kpezeshki/portaPLUTO/plutopack_frontend_pcb/plutopack/production/bom.csv

Designator | Footprint | Quantity | Value | LCSC Part #
A2 | RaspberryPi_Pico_SMD_HandSolder | 1 | RaspberryPi_Pico
C1, C12, C2, C9 | 0603 | 4 | 100n
C10, C11, C3, C4 | 0603 | 4 | 10u
C13, C14, C6, C8, FB1, FB2 | 0603 | 6 | ~
C15, C20 | 0603 | 2 | 0.1u
C16, C5 | CP_EIA-7343-31_Kemet-D | 2 | 100u
C17, C21 | 0603 | 2 | 4u7
C18, C7 | 0603 | 2 | 1u
C19 | 0603 | 1 | 0.47u
C22, C23, C24, C25, C26, C27, C28, C29, C30 | 0603 | 9 | 10n
D1, D2, D3, D4, D9 | 0603 | 5 | LED
D5 | D_SOD-123 | 1 | D_Schottky
D6, D7, D8 | SOT-23 | 3 | SP0502BAHT
J1 | PinHeader_2x10_P2.54mm_Vertical | 1 | Conn_02x10_Odd_Even
J2 | Amphenol_F32Q-1A7x1-11050_1x50-1MP_P0.5mm_Horizontal | 1 | Conn_01x50
J3 | BatteryHolder_Keystone_1042_1x18650 | 1 | Battery_Cell
J4 | PinSocket_1x06_P2.54mm_Horizontal | 1 | Conn_01x06_Pin
J5 | USB_C_Receptacle_GCT_USB4125-xx-x-0190_6P_TopMnt_Horizontal | 1 | USB_C_Receptacle_PowerOnly_6P
J6 | PinSocket_2x05_P1.27mm_Vertical_SMD | 1 | Conn_02x05_Odd_Even
JP1, JP2, JP3, JP4 | SolderJumper-2_P1.3mm_Bridged_RoundedPad1.0x1.5mm | 4 | Jumper_2_Bridged
L1, L2 | L_12x12mm_H4.5mm | 2 | 1u2
Q1, Q4 | SOT-23 | 2 | AO3401A
Q2, Q3 | SOT-23 | 2 | AO3400A
R1, R2, R3, R32, R33, R4 | 0603 | 6 | 10
R10, R13, R19, R20, R21, R22, R23, R24, R25, R26, R27, R28, R29, R30, R31, R7 | 0603 | 16 | 10k
R11, R12, R14, R15, R43, R44, R51, R52, R53, R54, R55, R56, R57, R58 | 0603 | 14 | 1k
R16 | 0603 | 1 | 10m
R17, R18, R49, R50 | 0603 | 4 | 5k1
R34, R35, R36, R37, R38, R39, R40 | 0603 | 7 | 0
R41, R42 | 0603 | 2 | 100k
R45 | 0603 | 1 | 330
R46, R47 | 0603 | 2 | 5M
R48 | 0603 | 1 | 2k2
R5 | 0603 | 1 | 1M6
R6, R9 | 0603 | 2 | 180k
R8 | 0603 | 1 | 1M
SW1, SW3, SW4, SW5, SW6, SW7, SW8 | SW_Push_1P1T_NO_CK_KSC6xxG | 7 | SW_Push
SW10 | SW_Slide_SPDT_Straight_CK_OS102011MS2Q | 1 | SW_SPDT
SW2 | RotaryEncoder_Alps_EC12E_Vertical_H20mm | 1 | RotaryEncoder
TP1, TP2, TP3, TP4, TP5 | TestPoint_THTPad_D1.5mm_Drill0.7mm | 5 | TestPoint
TP6, TP7, TP8 | TestPoint_Pad_D1.0mm | 3 | TestPoint
U1 | VQFN-16-1EP_3x3mm_P0.5mm_EP1.6x1.6mm | 1 | BQ24075RGT
U2 | SOP65P640X120-16N | 1 | TSC2007IPWR
U3, U5 | QFN14_1 | 2 | TPS63020
U4 | Texas_S-PDSO-N12 | 1 | BQ27441-G1
U6 | WSON-6_1.5x1.5mm_P0.5mm | 1 | BQ297xy
U7 | TSSOP-20_4.4x6.5mm_P0.65mm | 1 | TXS0108EPW
