kpezeshki/portaPLUTO/plutopack_frontend_pcb/plutopack/production/plutopack_V6_JLC_assembly_bom.csv

Comment | Designator | Footprint | JLCPCB Part #
100n | C1, C12, C2, C9 | 0603 | C1591
10u | C10, C11, C3, C4 | 0603 | C19702
0 (was ferrite) | FB1, FB2 | 0603 | C95177
10u (conv. output) | C14, C6 | 0603 | C19702
0.1u | C15, C20 | 0603 | C1591
4u7 | C17, C21 | 0603 | C19666
1u | C18, C7 | 0603 | C15849
0.47u | C19 | 0603 | C1623
10n | C22, C23, C24, C25, C26, C27, C28, C29, C30 | 0603 | C57112
LED | D1, D2, D3, D4, D9 | 0603 | C2286
D_Schottky | D5 | D_SOD-123 | C8598
SP0502BAHT | D6, D7, D8 | SOT-23 | C32677
AO3401A | Q1, Q4 | SOT-23 | C15127
AO3400A | Q2, Q3 | SOT-23 | C20917
10 | R1, R2, R3, R32, R33, R4 | 0603 | C22859
10k | R10, R13, R19, R20, R21, R22, R23, R24, R25, R26, R27, R28, R29, R30, R31, R7 | 0603 | C98220
1k | R11, R12, R14, R15, R43, R44, R51, R52, R53, R54, R55, R56, R57, R58 | 0603 | C21190
5k1 | R17, R18, R49, R50 | 0603 | C23186
0 | R34, R35, R36, R37, R38, R39, R40 | 0603 | C95177
100k | R41, R42 | 0603 | C25803
330 | R45 | 0603 | C23138
2k2 | R48 | 0603 | C4190
1M | R8 | 0603 | C22935
BQ24075RGT | U1 | VQFN-16-1EP_3x3mm_P0.5mm_EP1.6x1.6mm | C15464
TPS63020 | U3, U5 | QFN14_1 | C15483
BQ27441-G1 | U4 | Texas_S-PDSO-N12 | C473397
BQ297xy | U6 | WSON-6_1.5x1.5mm_P0.5mm | C183096
