kpezeshki/portaPLUTO/plutopack_frontend_pcb/plutopack/plutopack.step

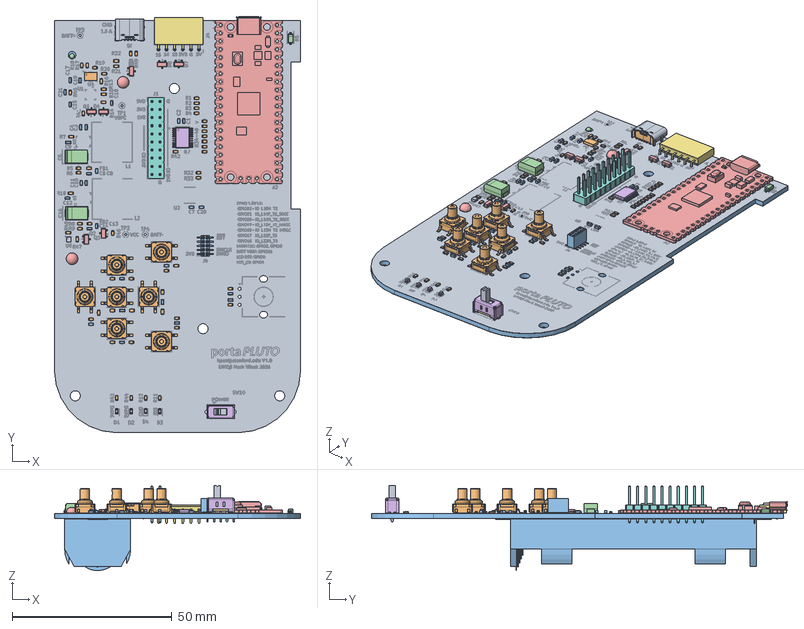
[picture p1: CAD file, 2026-08-21]
plutopack_frontend_pcb/plutopack/plutopack.step
77.0 x 130.2 x 26.7 mm
R_0603_1608Metric x 59
C_0603_1608Metric x 28
CP_EIA-7343-31_Kemet-D x 2
SOT-23 x 7
SW_Slide_SPDT_Straight_CK_OS102011MS2Q
SW_Push_1P1T_NO_CK_KSC6xxG x 7
PinSocket_2x05_P1.27mm_Vertical_SMD
D_SOD-123
RaspberryPi_Pico_Module_KiCad
LED_0603_1608Metric x 4
USB_C_Receptacle_GCT_USB4125-xx-x-0190_6P_TopMnt_Horizontal
TSSOP-20_4.4x6.5mm_P0.65mm
PinSocket_1x06_P2.54mm_Horizontal
PinHeader_2x10_P2.54mm_Vertical
WSON-6_1.5x1.5mm_P0.5mm
Texas_S-PDSO-N12
BatteryHolder_Keystone_1042_1x18650
plutopack_silkscreen
plutopack_soldermask
plutopack_PCB
