kpezeshki/portaPLUTO/plutopack_frontend_pcb/TPS63020/TPS63020.step

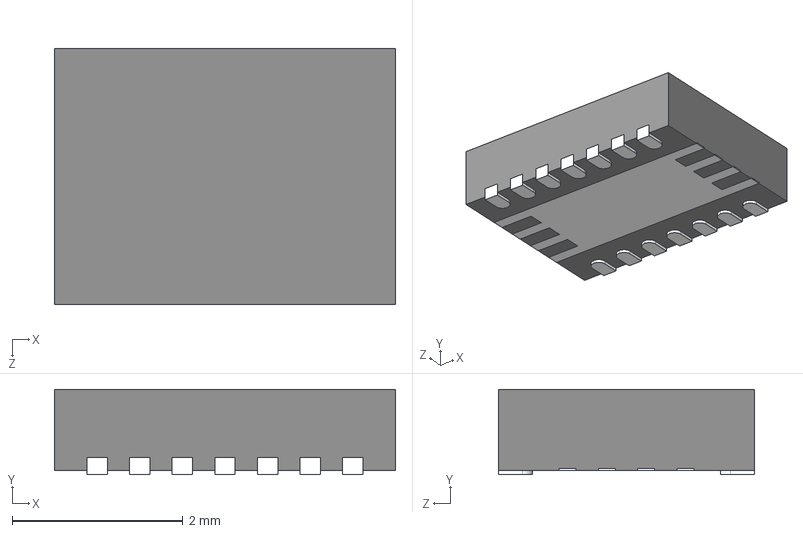
[picture p2: CAD file, 2026-08-21]
plutopack_frontend_pcb/TPS63020/TPS63020.step
4.00 x 1.00 x 3.00 mm
