kpezeshki/portaPLUTO/(list of files, cad)

Other CAD files:
plutopack_mechanics/Al_Midplate.f3d
plutopack_mechanics/buffer_block_bottom.f3d
plutopack_mechanics/cover_back_full.f3d
plutopack_mechanics/knob_ec12.f3d
plutopack_mechanics/knob_ec12_3dprint.f3d
plutopack_mechanics/knob_ec12_insert.f3d
plutopack_mechanics/pcb_display_mount.f3d
