kpezeshki/portaPLUTO/plutopack_mechanics/Al_Midplate_for_ext_machining Drawing.pdf

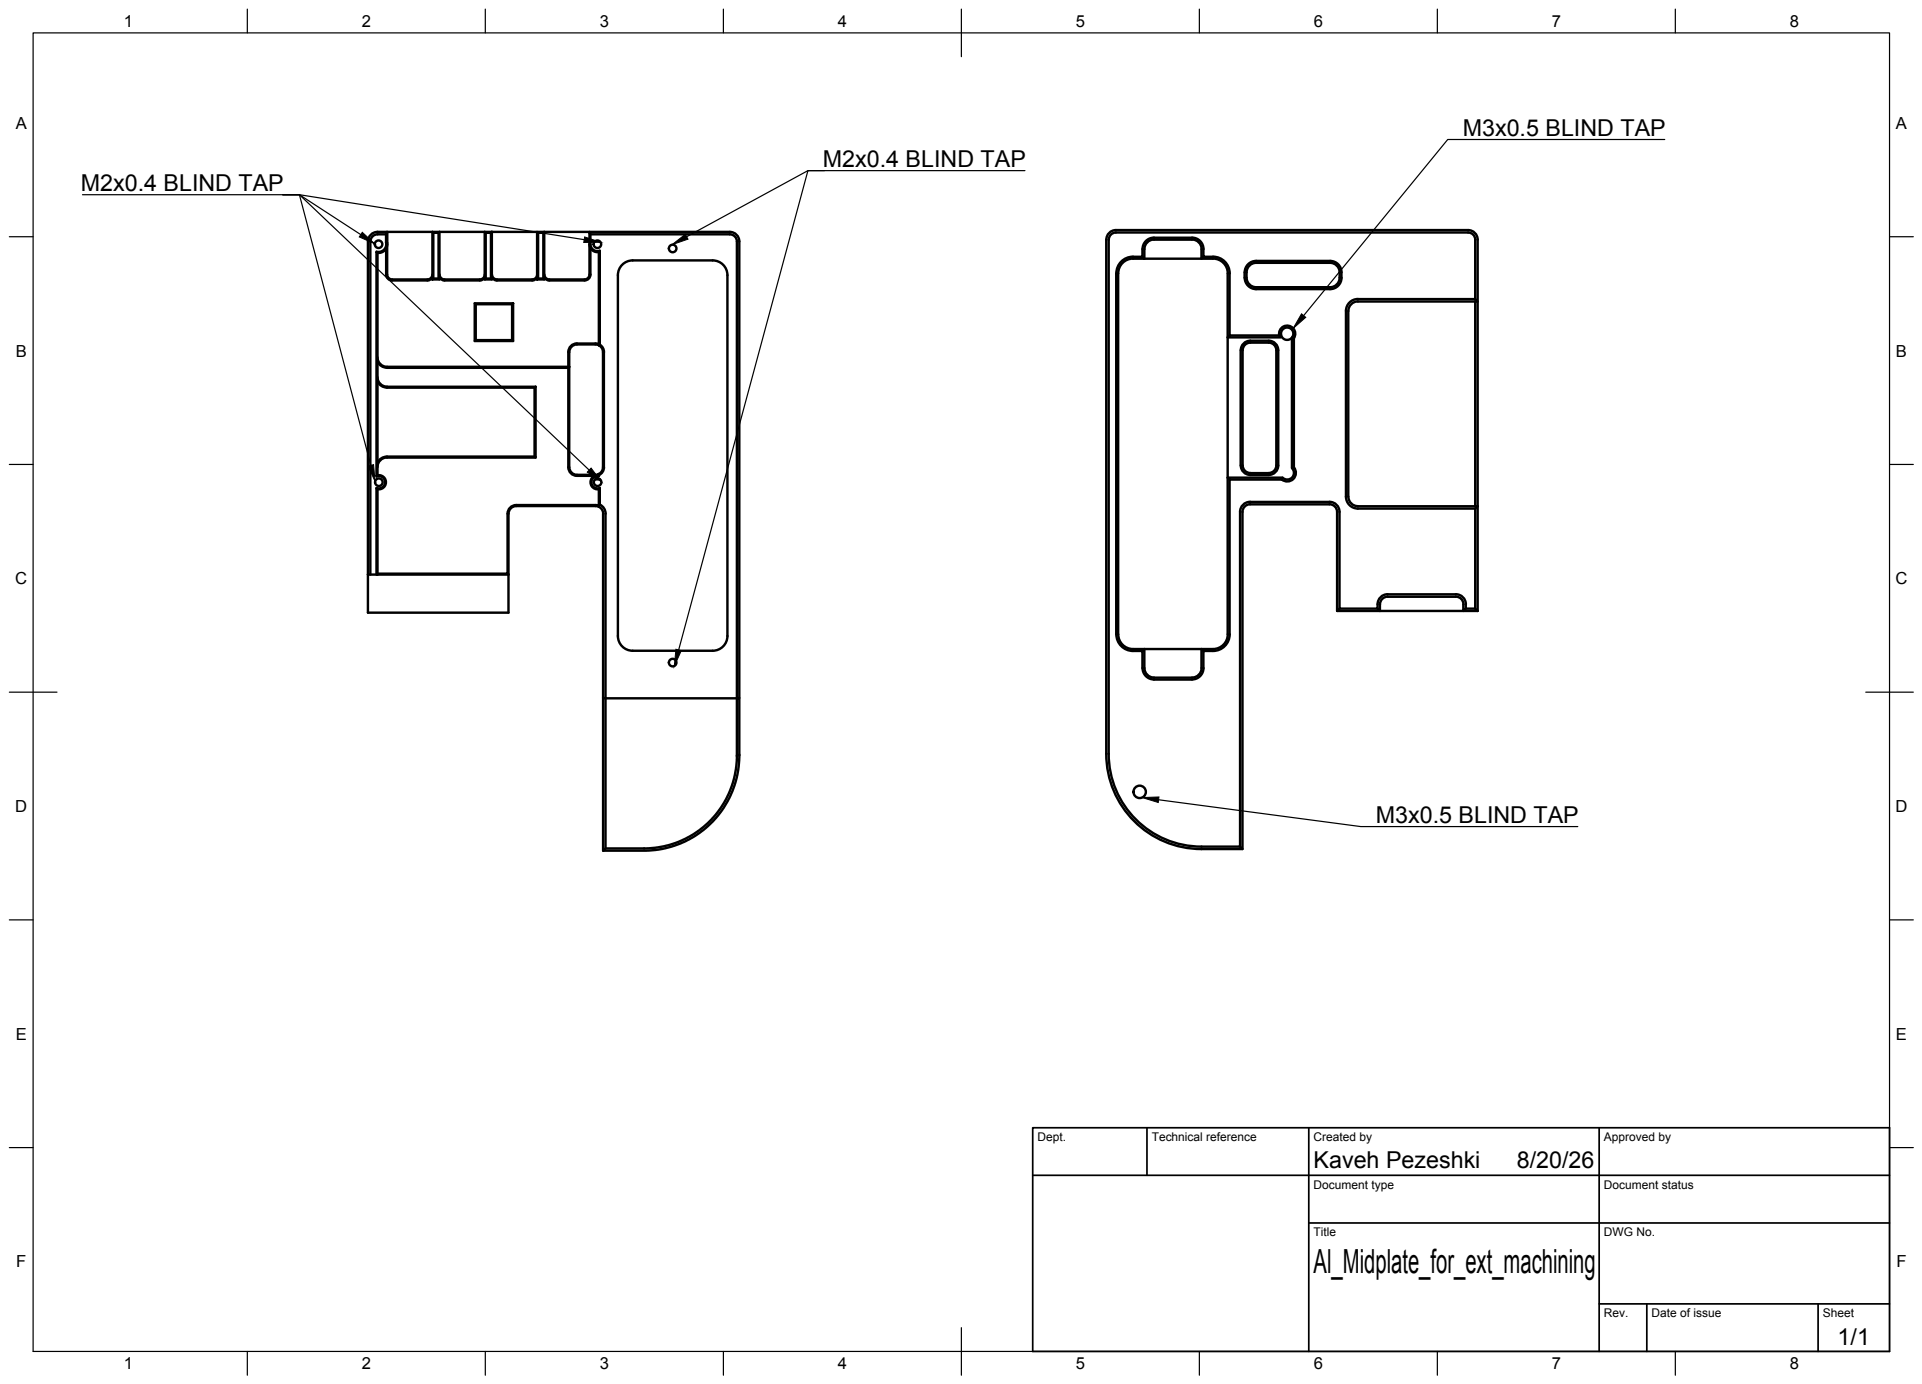
[picture p3: page 1]
Title; DWG No.; Rev.; Date of issue; Sheet; M3x0.5 BLIND TAP; M2x0.4 BLIND TAP

Dept. | Technical reference | Created by Kaveh Pezeshki 8/20/26 | Approved by

Document type | Document status
