kpezeshki/portaPLUTO/plutopack_frontend_pcb/plutopack/plutopack.kicad_pcb

## KiCad design plutopack_frontend_pcb/plutopack/plutopack.kicad_pcb (2026-10-26)

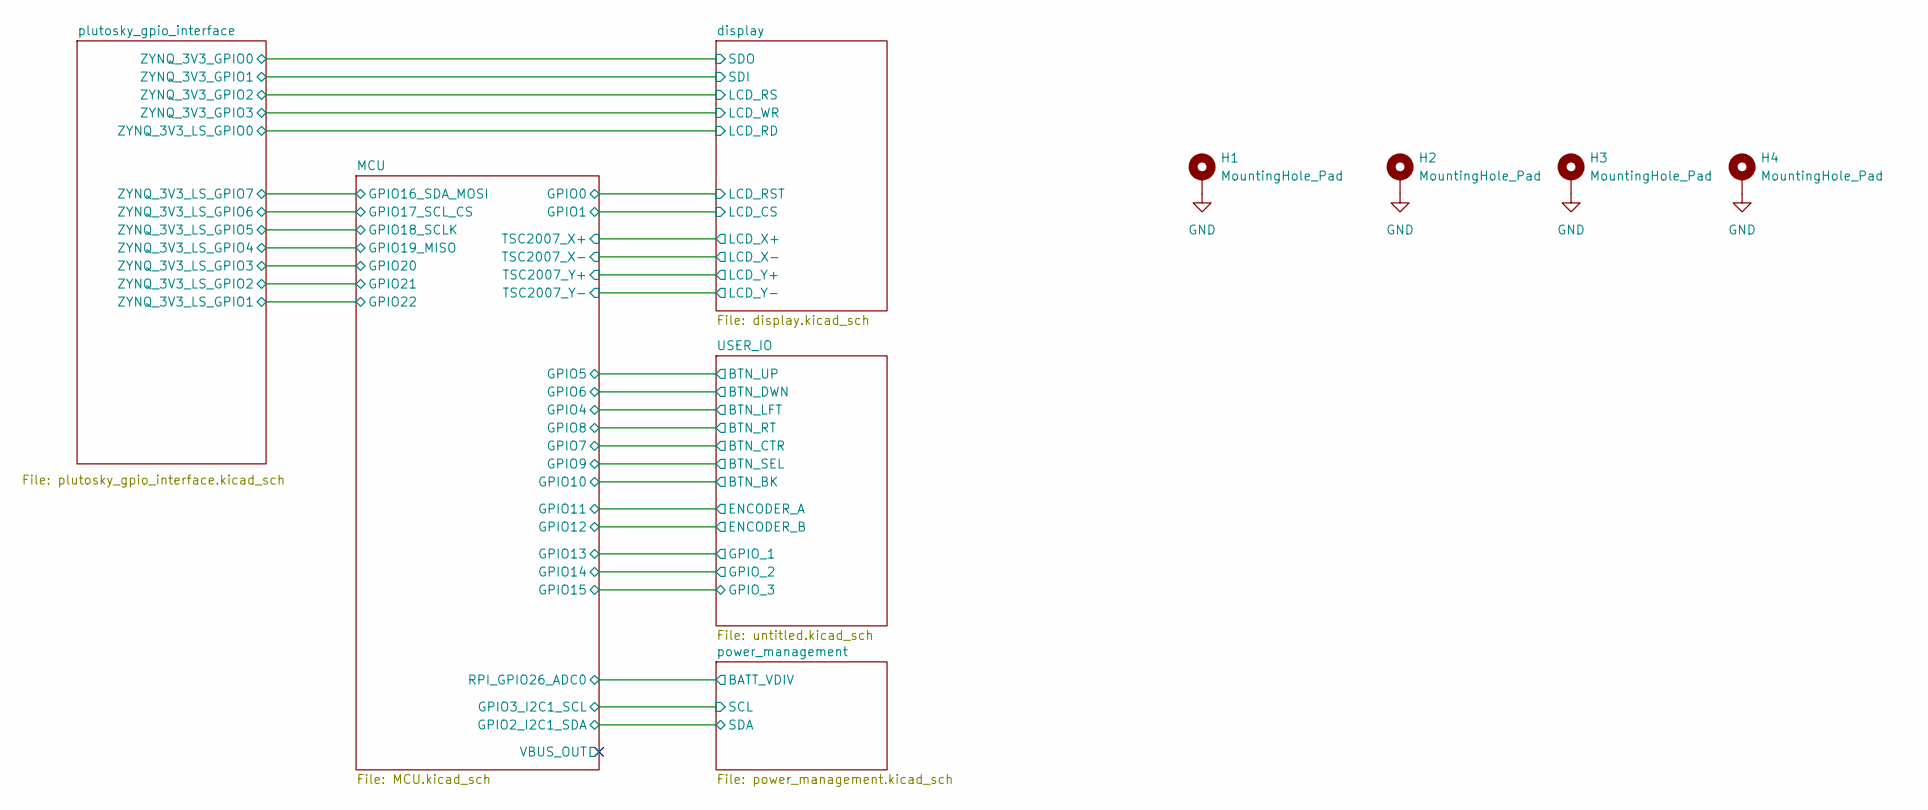
[picture p4: schematic plutopack.kicad_sch]

Parts:
H1, H2, H3, H4: MountingHole_Pad; MountingHole_3.2mm_M3_DIN965_Pad

Connections:
GND: H1.1, H2.1, H3.1, H4.1; also elsewhere on the board

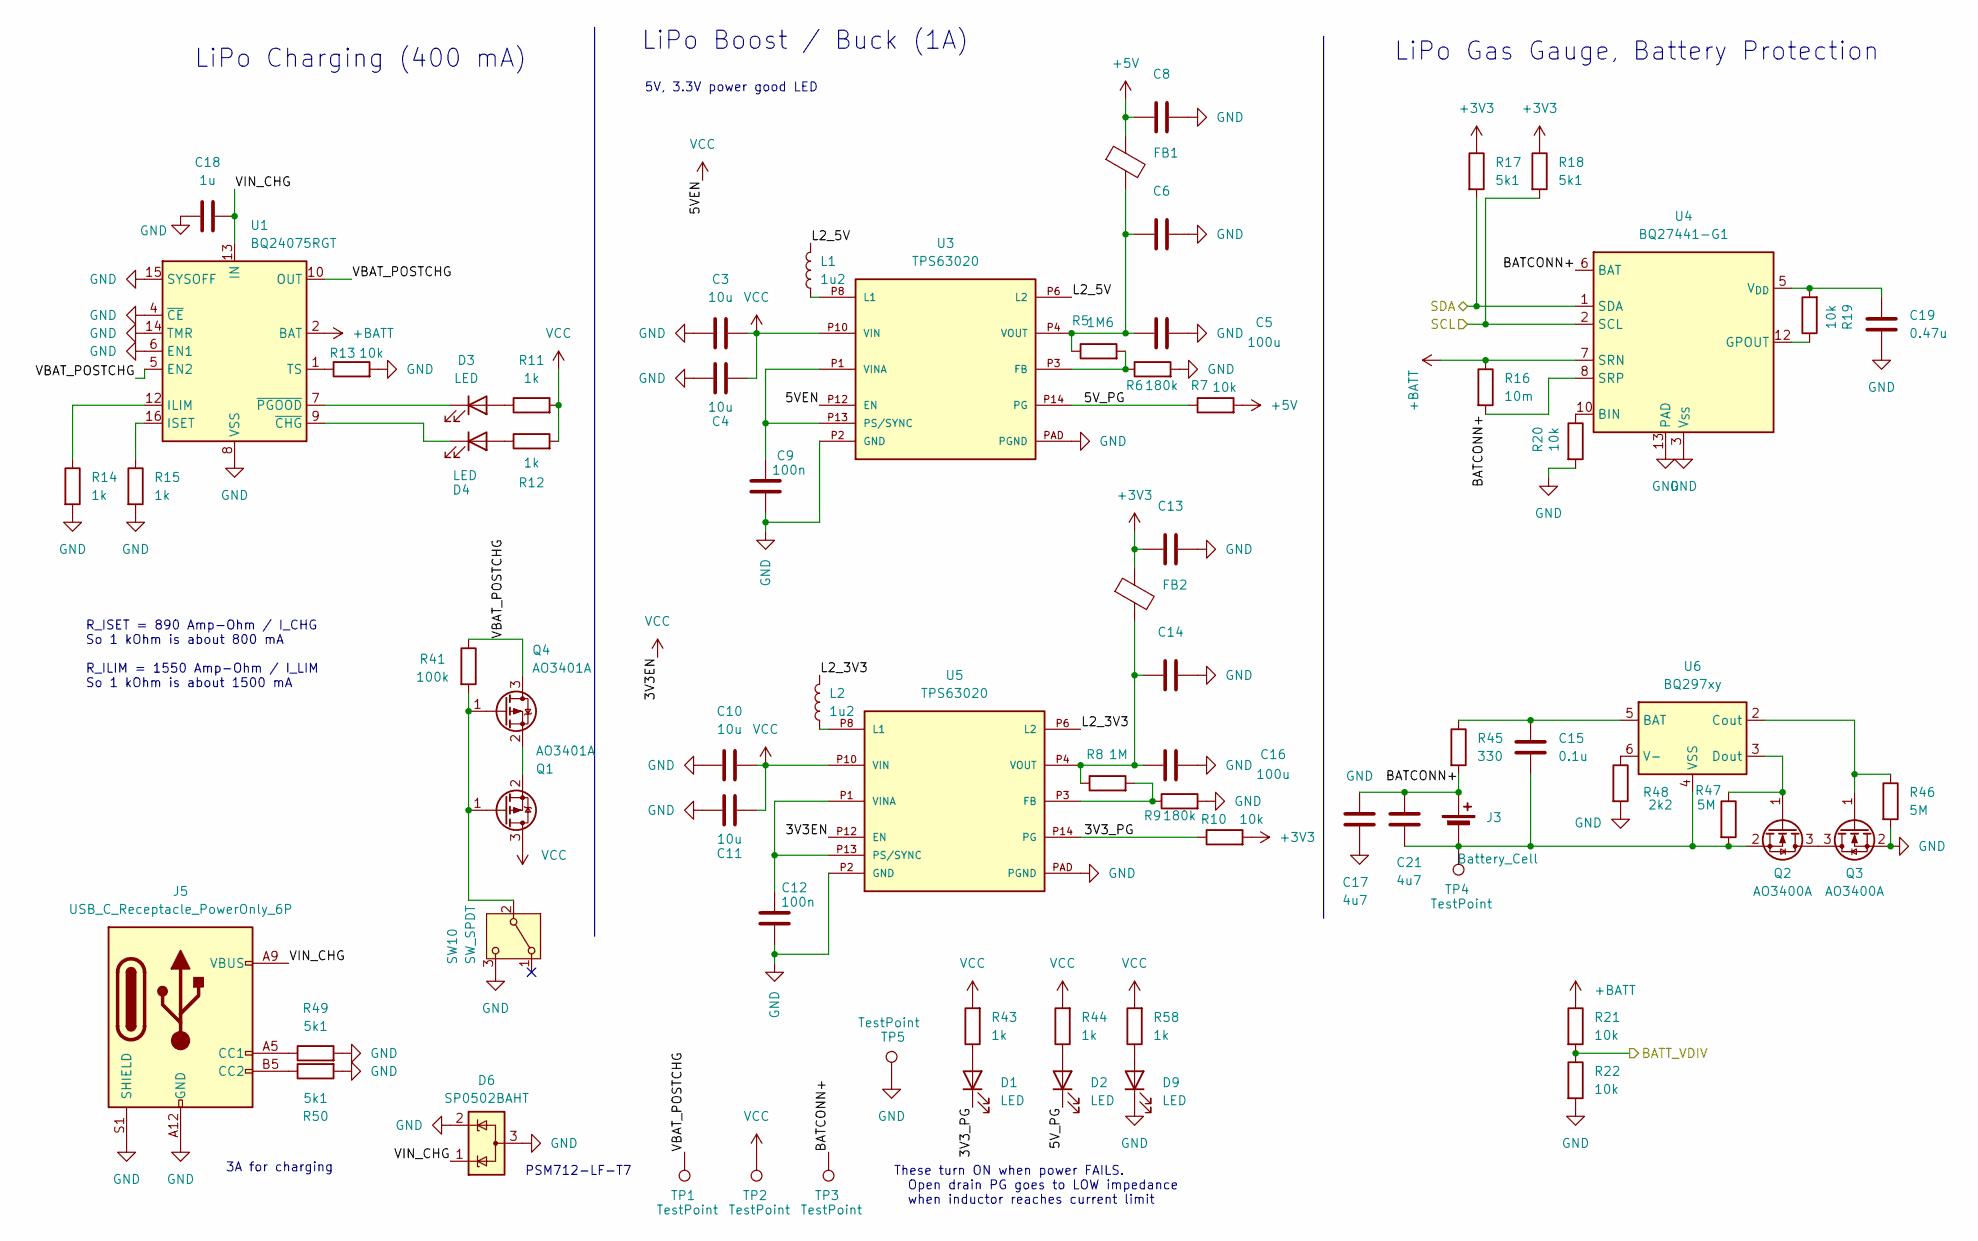
[picture p5: schematic power_management.kicad_sch]

Parts:
C3, C4, C10, C11: 10u; C_0603_1608Metric
C5, C16: 100u; CP_EIA-7343-31_Kemet-D
C6, C8, C13, C14: C_0603_1608Metric
C9, C12: 100n; C_0603_1608Metric
C15: 0.1u; C_0603_1608Metric
C17, C21: 4u7; C_0603_1608Metric
C18: 1u; C_0603_1608Metric
C19: 0.47u; C_0603_1608Metric
D1, D2, D3, D4, D9: LED; LED_0603_1608Metric
D6: SP0502BAHT; SOT-23
FB1, FB2: R_0603_1608Metric
J3: Battery_Cell; BatteryHolder_Keystone_1042_1x18650
J5: USB_C_Receptacle_PowerOnly_6P; USB_C_Receptacle_GCT_USB4125-xx-x-0190_6P_TopMnt_Horizontal
L1, L2: 1u2; L_12x12mm_H4.5mm
Q1, Q4: AO3401A; SOT-23
Q2, Q3: AO3400A; SOT-23
R5: 1M6; R_0603_1608Metric
R6, R9: 180k; R_0603_1608Metric
R7, R10, R13, R19, R20, R21, R22: 10k; R_0603_1608Metric
R8: 1M; R_0603_1608Metric
R11, R12, R14, R15, R43, R44, R58: 1k; R_0603_1608Metric
R16: 10m; R_0603_1608Metric
R17, R18, R49, R50: 5k1; R_0603_1608Metric
R41: 100k; R_0603_1608Metric
R45: 330; R_0603_1608Metric
R46, R47: 5M; R_0603_1608Metric
R48: 2k2; R_0603_1608Metric
SW10: SW_SPDT; SW_Slide_SPDT_Straight_CK_OS102011MS2Q
TP1, TP2, TP3, TP4, TP5: TestPoint; TestPoint_THTPad_D1.5mm_Drill0.7mm
U1: BQ24075RGT; VQFN-16-1EP_3x3mm_P0.5mm_EP1.6x1.6mm
U3, U5: TPS63020; QFN14_1
U4: BQ27441-G1; Texas_S-PDSO-N12
U6: BQ297xy; WSON-6_1.5x1.5mm_P0.5mm

Connections:
+3V3: C13.2, FB2.1, R10.2, R17.1, R18.1; also elsewhere on the board
+5V: C8.2, FB1.1, R7.2; also elsewhere on the board
+BATT: R16.1, R21.1, U1.2 (BAT), U1.3 (BAT), U4.7 (SRN)
/MCU/GPIO2_I2C1_SDA: R17.2, U4.1 (SDA); also elsewhere on the board
/MCU/GPIO3_I2C1_SCL: R18.2, U4.2 (SCL); also elsewhere on the board
/MCU/RPI_GPIO26_ADC0: R21.2, R22.1; also elsewhere on the board
/power_management/3V3_PG: D1.1 (K), R10.1, U5.P14 (PG)
/power_management/5V_PG: D2.1 (K), R7.1, U3.P14 (PG)
/power_management/BATCONN+: C17.2, C21.2, J3.1 (+), R16.2, R45.2, TP3.1, U4.6 (BAT), U4.8 (SRP)
/power_management/L2_3V3: L2.2, U5.P6 (L2), U5.P7 (L2)
/power_management/L2_5V: L1.2, U3.P6 (L2), U3.P7 (L2)
/power_management/VBAT_POSTCHG: Q4.3 (D), R41.1, TP1.1, U1.5 (EN2), U1.10 (OUT), U1.11 (OUT)
/power_management/VIN_CHG: C18.2, D6.1 (K), J5.A9 (VBUS), J5.B9 (VBUS), U1.13 (IN)
GND: C3.1, C4.1, C5.1, C6.1, C8.1, C9.1, C10.1, C11.1, C12.1, C13.1, C14.1, C16.1, C17.1, C18.1, C19.1, D6.2 (K), D6.3 (A), D9.1 (K), J5.A12 (GND), J5.B12 (GND), J5.S1 (SHIELD), Q3.2 (S), R6.2, R9.2, R13.2, R14.2, R15.2, R20.2, R22.2, R46.2, R48.2, R49.2, R50.2, SW10.3 (C), TP5.1, U1.4 (~CE), U1.6 (EN1), U1.8 (VSS), U1.14 (TMR), U1.15 (SYSOFF), U1.17 (VSS), U3.P2 (GND), U3.PAD (PGND), U4.3 (V_{SS}), U4.13 (PAD), U5.P2 (GND), U5.PAD (PGND); also elsewhere on the board
unnamed: C5.2, C6.2, FB1.2, R5.1, U3.P4 (VOUT), U3.P5 (VOUT)
unnamed: C14.2, C16.2, FB2.2, R8.1, U5.P4 (VOUT), U5.P5 (VOUT)
unnamed: D1.2 (A), R43.1
unnamed: D2.2 (A), R44.1
unnamed: D3.2 (A), R11.1
unnamed: D3.1 (K), U1.7 (~PGOOD)
unnamed: D4.2 (A), R12.1
unnamed: D4.1 (K), U1.9 (~CHG)
unnamed: D9.2 (A), R58.1
unnamed: C15.2, C21.1, J3.2 (-), Q2.2 (S), R47.2, TP4.1, U6.4 (VSS)
unnamed: J5.A5 (CC1), R49.1
unnamed: J5.B5 (CC2), R50.1
unnamed: L1.1, U3.P8 (L1), U3.P9 (L1)
unnamed: L2.1, U5.P8 (L1), U5.P9 (L1)
unnamed: Q1.1 (G), Q4.1 (G), R41.2, SW10.2 (B)
unnamed: Q1.2 (S), Q4.2 (S)
unnamed: Q2.3 (D), Q3.3 (D)
unnamed: Q2.1 (G), R47.1, U6.3 (Dout)
unnamed: Q3.1 (G), R46.1, U6.2 (Cout)
unnamed: R14.1, U1.12 (ILIM)
unnamed: R15.1, U1.16 (ISET)
unnamed: R13.1, U1.1 (TS)
unnamed: R5.2, R6.1, U3.P3 (FB)
unnamed: C9.2, U3.P1 (VINA), U3.P13 (PS/SYNC)
unnamed: R20.1, U4.10 (BIN)
unnamed: R19.1, U4.12 (GPOUT)
unnamed: C19.2, R19.2, U4.5 (V_{DD})
unnamed: R8.2, R9.1, U5.P3 (FB)
unnamed: C12.2, U5.P1 (VINA), U5.P13 (PS/SYNC)
unnamed: C15.1, R45.1, U6.5 (BAT)
unnamed: R48.1, U6.6 (V-)
VCC: C3.2, C4.2, C10.2, C11.2, Q1.3 (D), R11.2, R12.2, R43.2, R44.2, R58.2, TP2.1, U3.P10 (VIN), U3.P11 (VIN), U3.P12 (EN), U5.P10 (VIN), U5.P11 (VIN), U5.P12 (EN)

Notes on the sheet:
3A for charging
LiPo Gas Gauge, Battery Protection
5V, 3.3V power good LED
LiPo Charging (400 mA)
These turn ON when power FAILS. Open drain PG goes to LOW impedance when inductor reaches current limit
R_ILIM = 1550 Amp-Ohm / I_LIM So 1 kOhm is about 1500 mA
LiPo Boost / Buck (1A)
R_ISET = 890 Amp-Ohm / I_CHG So 1 kOhm is about 800 mA
PSM712-LF-T7

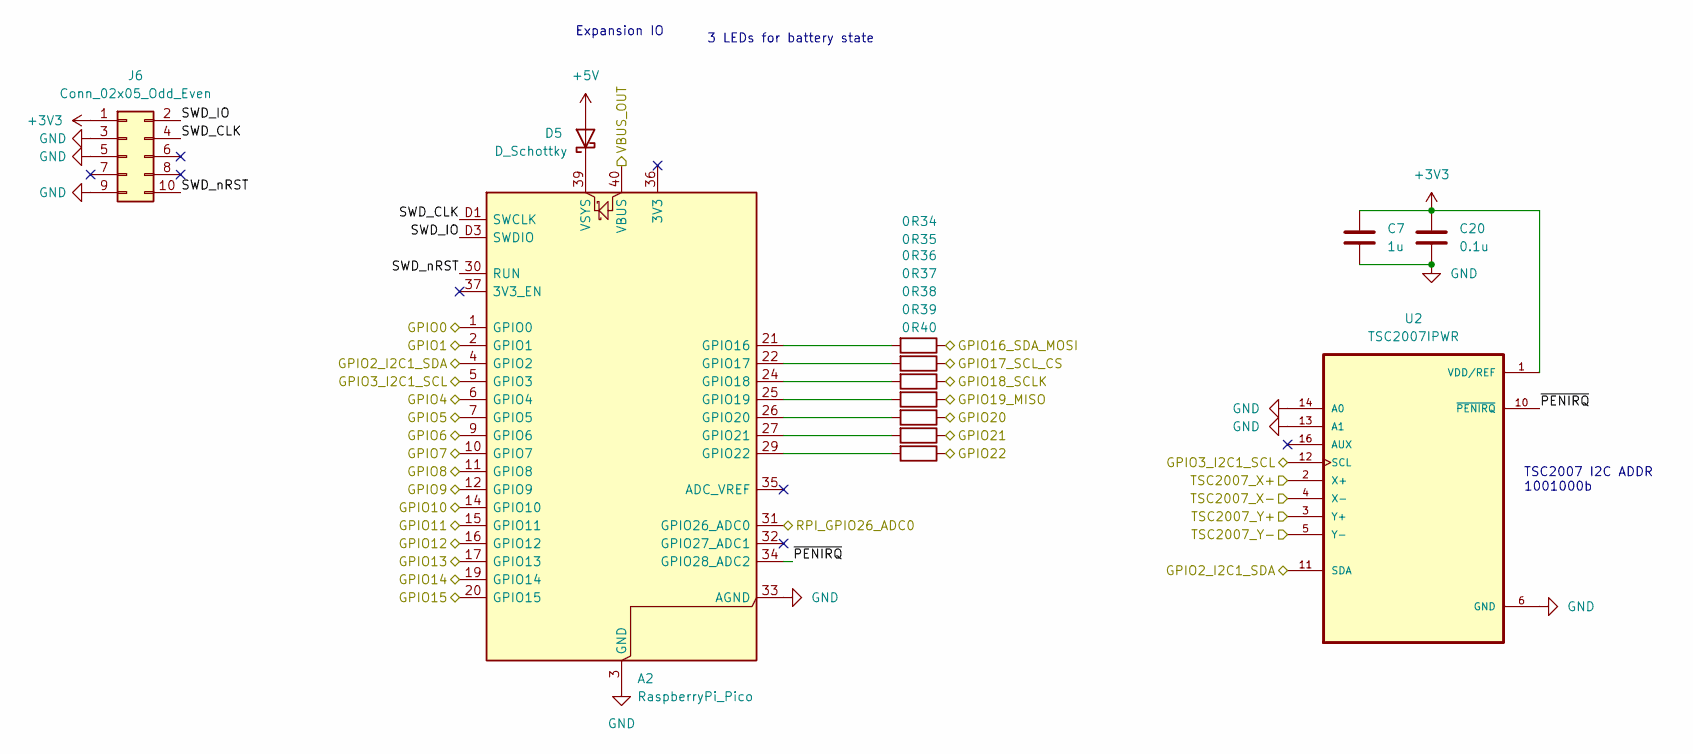
[picture p6: schematic MCU.kicad_sch]

Parts:
A2: RaspberryPi_Pico; RaspberryPi_Pico_SMD_HandSolder
C7: 1u; C_0603_1608Metric
C20: 0.1u; C_0603_1608Metric
D5: D_Schottky; D_SOD-123
J6: Conn_02x05_Odd_Even; PinSocket_2x05_P1.27mm_Vertical_SMD
R34, R35, R36, R37, R38, R39, R40: 0; R_0603_1608Metric
U2: TSC2007IPWR; SOP65P640X120-16N

Connections:
+3V3: C7.1, C20.2, J6.1, U2.1 (VDD/REF); also elsewhere on the board
+5V: D5.2 (A); also elsewhere on the board
/MCU/GPIO0: A2.1 (GPIO0); also elsewhere on the board
/MCU/GPIO1: A2.2 (GPIO1); also elsewhere on the board
/MCU/GPIO2_I2C1_SDA: A2.4 (GPIO2), U2.11 (SDA); also elsewhere on the board
/MCU/GPIO3_I2C1_SCL: A2.5 (GPIO3), U2.12 (SCL); also elsewhere on the board
/MCU/GPIO4: A2.6 (GPIO4); also elsewhere on the board
/MCU/GPIO5: A2.7 (GPIO5); also elsewhere on the board
/MCU/GPIO6: A2.9 (GPIO6); also elsewhere on the board
/MCU/GPIO7: A2.10 (GPIO7); also elsewhere on the board
/MCU/GPIO8: A2.11 (GPIO8); also elsewhere on the board
/MCU/GPIO9: A2.12 (GPIO9); also elsewhere on the board
/MCU/GPIO10: A2.14 (GPIO10); also elsewhere on the board
/MCU/GPIO11: A2.15 (GPIO11); also elsewhere on the board
/MCU/GPIO12: A2.16 (GPIO12); also elsewhere on the board
/MCU/GPIO13: A2.17 (GPIO13); also elsewhere on the board
/MCU/GPIO14: A2.19 (GPIO14); also elsewhere on the board
/MCU/GPIO15: A2.20 (GPIO15); also elsewhere on the board
/MCU/GPIO16_SDA_MOSI: R34.1; also elsewhere on the board
/MCU/GPIO17_SCL_CS: R35.1; also elsewhere on the board
/MCU/GPIO18_SCLK: R36.1; also elsewhere on the board
/MCU/GPIO19_MISO: R37.1; also elsewhere on the board
/MCU/GPIO20: R38.1; also elsewhere on the board
/MCU/GPIO21: R39.1; also elsewhere on the board
/MCU/GPIO22: R40.1; also elsewhere on the board
/MCU/RPI_GPIO26_ADC0: A2.31 (GPIO26_ADC0); also elsewhere on the board
/MCU/SWD_CLK: A2.D1 (SWCLK), J6.4
/MCU/SWD_IO: A2.D3 (SWDIO), J6.2
/MCU/SWD_nRST: A2.30 (RUN), J6.10
/MCU/TSC2007_X+: U2.2 (X+); also elsewhere on the board
/MCU/TSC2007_X-: U2.4 (X-); also elsewhere on the board
/MCU/TSC2007_Y+: U2.3 (Y+); also elsewhere on the board
/MCU/TSC2007_Y-: U2.5 (Y-); also elsewhere on the board
/MCU/VBUS_OUT: A2.40 (VBUS)
/MCU/~PENIRQ: A2.34 (GPIO28_ADC2), U2.10 (~PENIRQ)
GND: A2.3 (GND), A2.8 (GND), A2.13 (GND), A2.18 (GND), A2.23 (GND), A2.28 (GND), A2.33 (AGND), A2.38 (GND), A2.D2 (GND), C7.2, C20.1, J6.3, J6.5, J6.9, U2.6 (GND), U2.13 (A1), U2.14 (A0); also elsewhere on the board
unnamed: A2.21 (GPIO16), R34.2
unnamed: A2.22 (GPIO17), R35.2
unnamed: A2.24 (GPIO18), R36.2
unnamed: A2.25 (GPIO19), R37.2
unnamed: A2.26 (GPIO20), R38.2
unnamed: A2.27 (GPIO21), R39.2
unnamed: A2.29 (GPIO22), R40.2
unnamed: A2.39 (VSYS), D5.1 (K)

Notes on the sheet:
Expansion IO
3 LEDs for battery state
TSC2007 I2C ADDR 1001000b

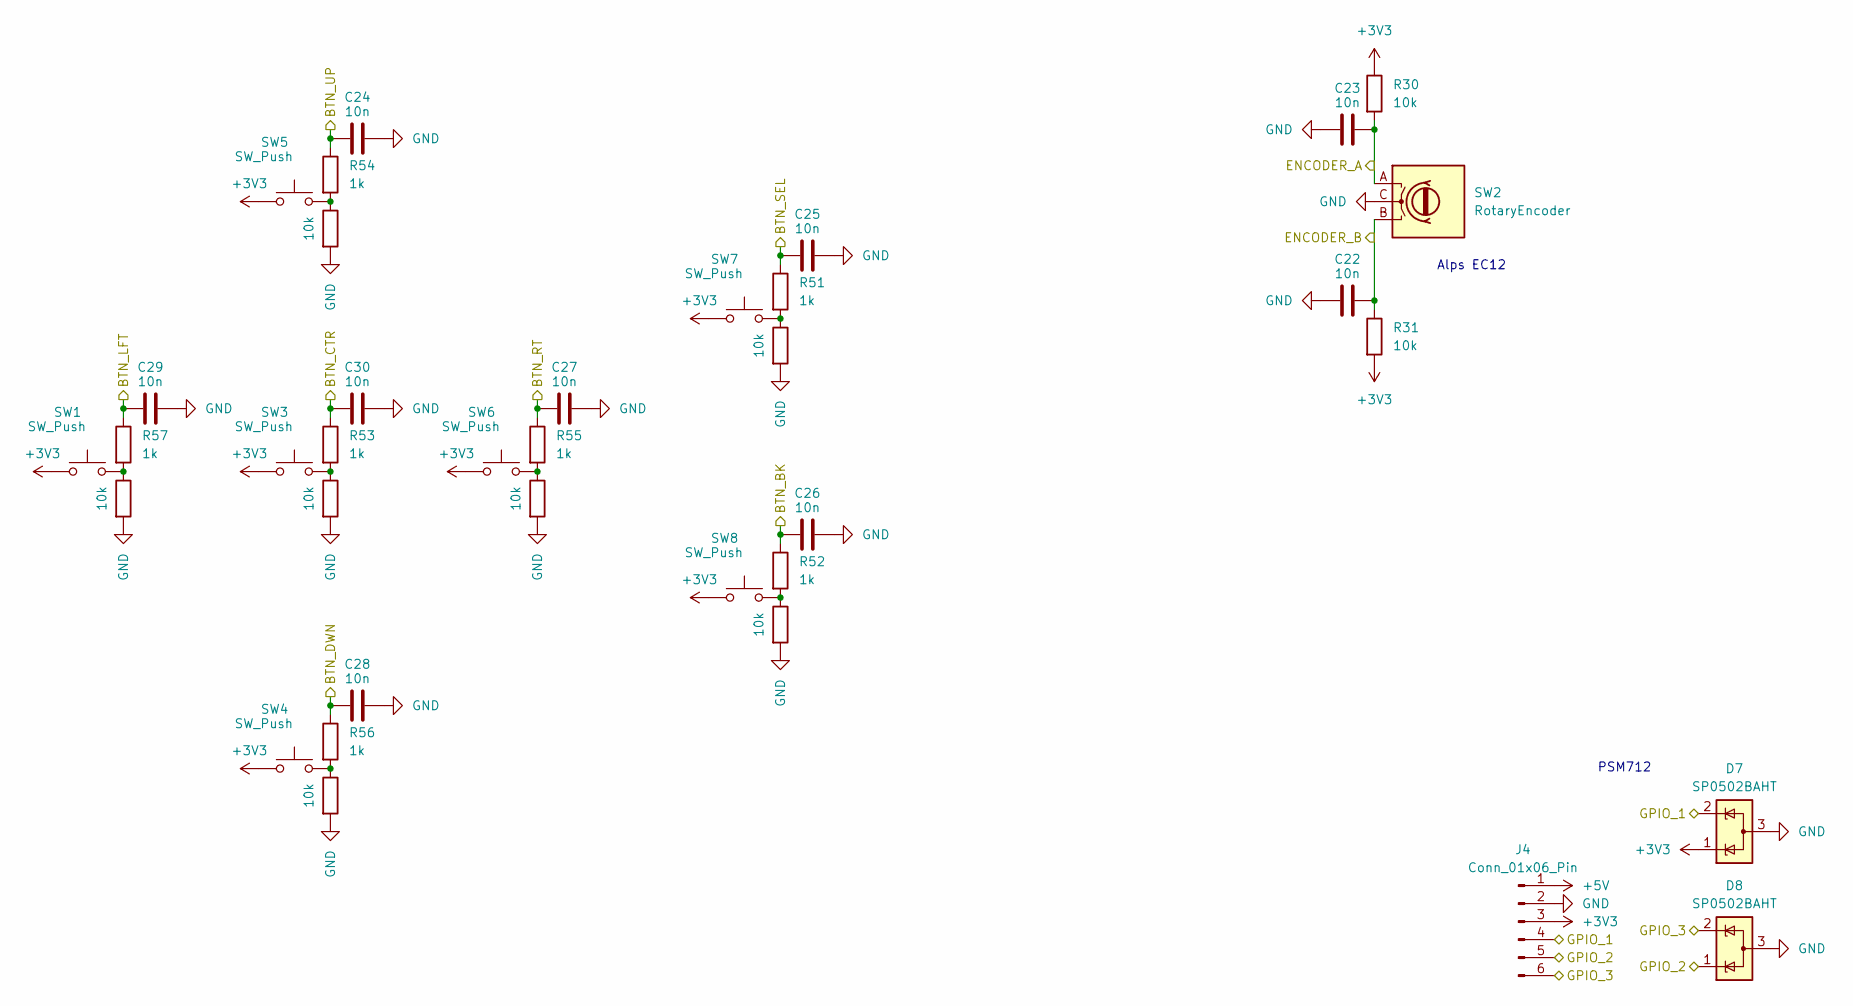
[picture p7: schematic untitled.kicad_sch]

Parts:
C22, C23, C24, C25, C26, C27, C28, C29, C30: 10n; C_0603_1608Metric
D7, D8: SP0502BAHT; SOT-23
J4: Conn_01x06_Pin; PinSocket_1x06_P2.54mm_Horizontal
R23, R24, R25, R26, R27, R28, R29, R30, R31: 10k; R_0603_1608Metric
R51, R52, R53, R54, R55, R56, R57: 1k; R_0603_1608Metric
SW1, SW3, SW4, SW5, SW6, SW7, SW8: SW_Push; SW_Push_1P1T_NO_CK_KSC6xxG
SW2: RotaryEncoder; RotaryEncoder_Alps_EC12E_Vertical_H20mm

Connections:
+3V3: D7.1 (K), J4.3, R30.1, R31.2, SW1.1, SW3.1, SW4.1, SW5.1, SW6.1, SW7.1, SW8.1; also elsewhere on the board
+5V: J4.1; also elsewhere on the board
/MCU/GPIO4: C29.1, R57.1; also elsewhere on the board
/MCU/GPIO5: C24.1, R54.1; also elsewhere on the board
/MCU/GPIO6: C28.1, R56.1; also elsewhere on the board
/MCU/GPIO7: C30.1, R53.1; also elsewhere on the board
/MCU/GPIO8: C27.1, R55.1; also elsewhere on the board
/MCU/GPIO9: C25.1, R51.1; also elsewhere on the board
/MCU/GPIO10: C26.1, R52.1; also elsewhere on the board
/MCU/GPIO11: C23.2, R30.2, SW2.A; also elsewhere on the board
/MCU/GPIO12: C22.2, R31.1, SW2.B; also elsewhere on the board
/MCU/GPIO13: D7.2 (K), J4.4; also elsewhere on the board
/MCU/GPIO14: D8.1 (K), J4.5; also elsewhere on the board
/MCU/GPIO15: D8.2 (K), J4.6; also elsewhere on the board
GND: C22.1, C23.1, C24.2, C25.2, C26.2, C27.2, C28.2, C29.2, C30.2, D7.3 (A), D8.3 (A), J4.2, R23.2, R24.2, R25.2, R26.2, R27.2, R28.2, R29.2, SW2.C; also elsewhere on the board
unnamed: R23.1, R53.2, SW3.2
unnamed: R24.1, R56.2, SW4.2
unnamed: R25.1, R54.2, SW5.2
unnamed: R26.1, R55.2, SW6.2
unnamed: R27.1, R57.2, SW1.2
unnamed: R28.1, R51.2, SW7.2
unnamed: R29.1, R52.2, SW8.2

Notes on the sheet:
PSM712
Alps EC12

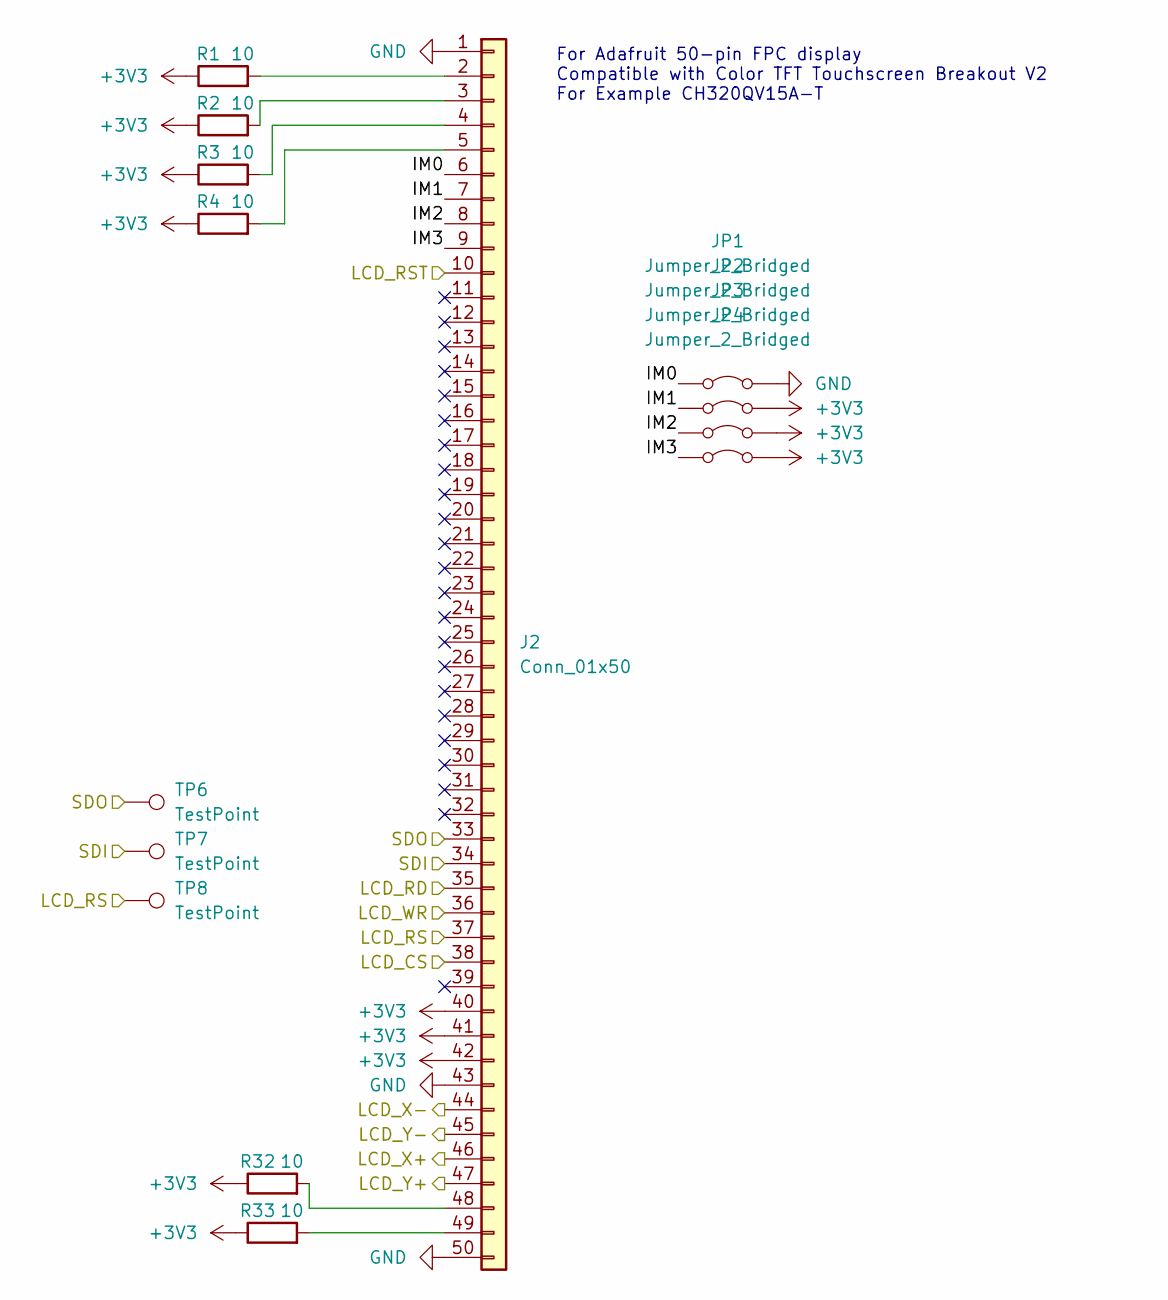
[picture p8: schematic display.kicad_sch]

Parts:
J2: Conn_01x50; Amphenol_F32Q-1A7x1-11050_1x50-1MP_P0.5mm_Horizontal
JP1, JP2, JP3, JP4: Jumper_2_Bridged; SolderJumper-2_P1.3mm_Bridged_RoundedPad1.0x1.5mm
R1, R2, R3, R4, R32, R33: 10; R_0603_1608Metric
TP6, TP7, TP8: TestPoint; TestPoint_Pad_D1.0mm

Connections:
+3V3: J2.40, J2.41, J2.42, JP2.2 (B), JP3.2 (B), JP4.2 (B), R1.1, R2.1, R3.1, R4.1, R32.1, R33.1; also elsewhere on the board
/MCU/GPIO0: J2.10; also elsewhere on the board
/MCU/GPIO1: J2.38; also elsewhere on the board
/MCU/TSC2007_X+: J2.46; also elsewhere on the board
/MCU/TSC2007_X-: J2.44; also elsewhere on the board
/MCU/TSC2007_Y+: J2.47; also elsewhere on the board
/MCU/TSC2007_Y-: J2.45; also elsewhere on the board
/display/IM0: J2.6, JP1.1 (A)
/display/IM1: J2.7, JP2.1 (A)
/display/IM2: J2.8, JP3.1 (A)
/display/IM3: J2.9, JP4.1 (A)
/display/LCD_RD: J2.35; also elsewhere on the board
/display/LCD_RS: J2.37, TP8.1; also elsewhere on the board
/display/LCD_WR: J2.36; also elsewhere on the board
/display/SDI: J2.34, TP7.1; also elsewhere on the board
/display/SDO: J2.33, TP6.1; also elsewhere on the board
GND: J2.1, J2.43, J2.50, JP1.2 (B); also elsewhere on the board
unnamed: J2.2, R1.2
unnamed: J2.3, R2.2
unnamed: J2.4, R3.2
unnamed: J2.5, R4.2
unnamed: J2.48, R32.2
unnamed: J2.49, R33.2

Notes on the sheet:
For Adafruit 50-pin FPC display Compatible with Color TFT Touchscreen Breakout V2 For Example CH320QV15A-T

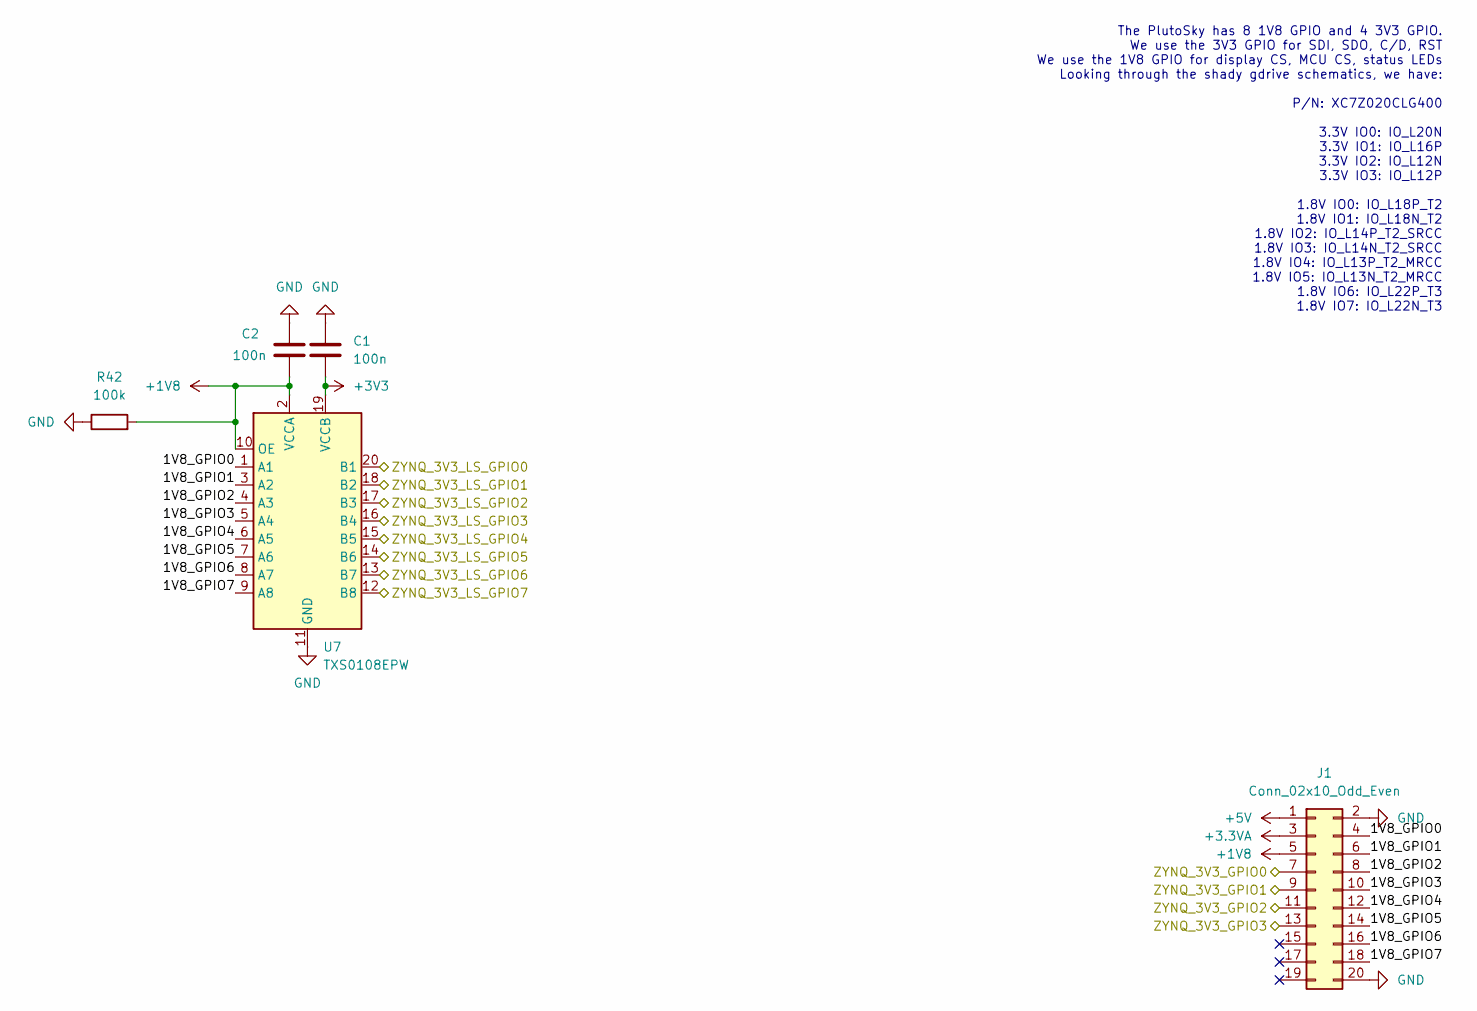
[picture p9: schematic plutosky_gpio_interface.kicad_sch]

Parts:
C1, C2: 100n; C_0603_1608Metric
J1: Conn_02x10_Odd_Even; PinHeader_2x10_P2.54mm_Vertical
R42: 100k; R_0603_1608Metric
U7: TXS0108EPW; TSSOP-20_4.4x6.5mm_P0.65mm

Connections:
+1V8: C2.1, J1.5, R42.2, U7.2 (VCCA), U7.10 (OE)
+3.3VA: J1.3
+3V3: C1.2, U7.19 (VCCB); also elsewhere on the board
+5V: J1.1; also elsewhere on the board
/MCU/GPIO16_SDA_MOSI: U7.12 (B8); also elsewhere on the board
/MCU/GPIO17_SCL_CS: U7.13 (B7); also elsewhere on the board
/MCU/GPIO18_SCLK: U7.14 (B6); also elsewhere on the board
/MCU/GPIO19_MISO: U7.15 (B5); also elsewhere on the board
/MCU/GPIO20: U7.16 (B4); also elsewhere on the board
/MCU/GPIO21: U7.17 (B3); also elsewhere on the board
/MCU/GPIO22: U7.18 (B2); also elsewhere on the board
/display/LCD_RD: U7.20 (B1); also elsewhere on the board
/display/LCD_RS: J1.11; also elsewhere on the board
/display/LCD_WR: J1.13; also elsewhere on the board
/display/SDI: J1.9; also elsewhere on the board
/display/SDO: J1.7; also elsewhere on the board
/plutosky_gpio_interface/1V8_GPIO0: J1.4, U7.1 (A1)
/plutosky_gpio_interface/1V8_GPIO1: J1.6, U7.3 (A2)
/plutosky_gpio_interface/1V8_GPIO2: J1.8, U7.4 (A3)
/plutosky_gpio_interface/1V8_GPIO3: J1.10, U7.5 (A4)
/plutosky_gpio_interface/1V8_GPIO4: J1.12, U7.6 (A5)
/plutosky_gpio_interface/1V8_GPIO5: J1.14, U7.7 (A6)
/plutosky_gpio_interface/1V8_GPIO6: J1.16, U7.8 (A7)
/plutosky_gpio_interface/1V8_GPIO7: J1.18, U7.9 (A8)
GND: C1.1, C2.2, J1.2, J1.20, R42.1, U7.11 (GND); also elsewhere on the board

Notes on the sheet:
The PlutoSky has 8 1V8 GPIO and 4 3V3 GPIO. We use the 3V3 GPIO for SDI, SDO, C/D, RST We use the 1V8 GPIO for display CS, MCU CS, status LEDs Looking through the shady gdrive schematics, we have: P/N: XC7Z020CLG400 3.3V IO0: IO_L20N 3.3V IO1: IO_L16P 3.3V IO2: IO_L12N 3.3V IO3: IO_L12P 1.8V IO0: I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

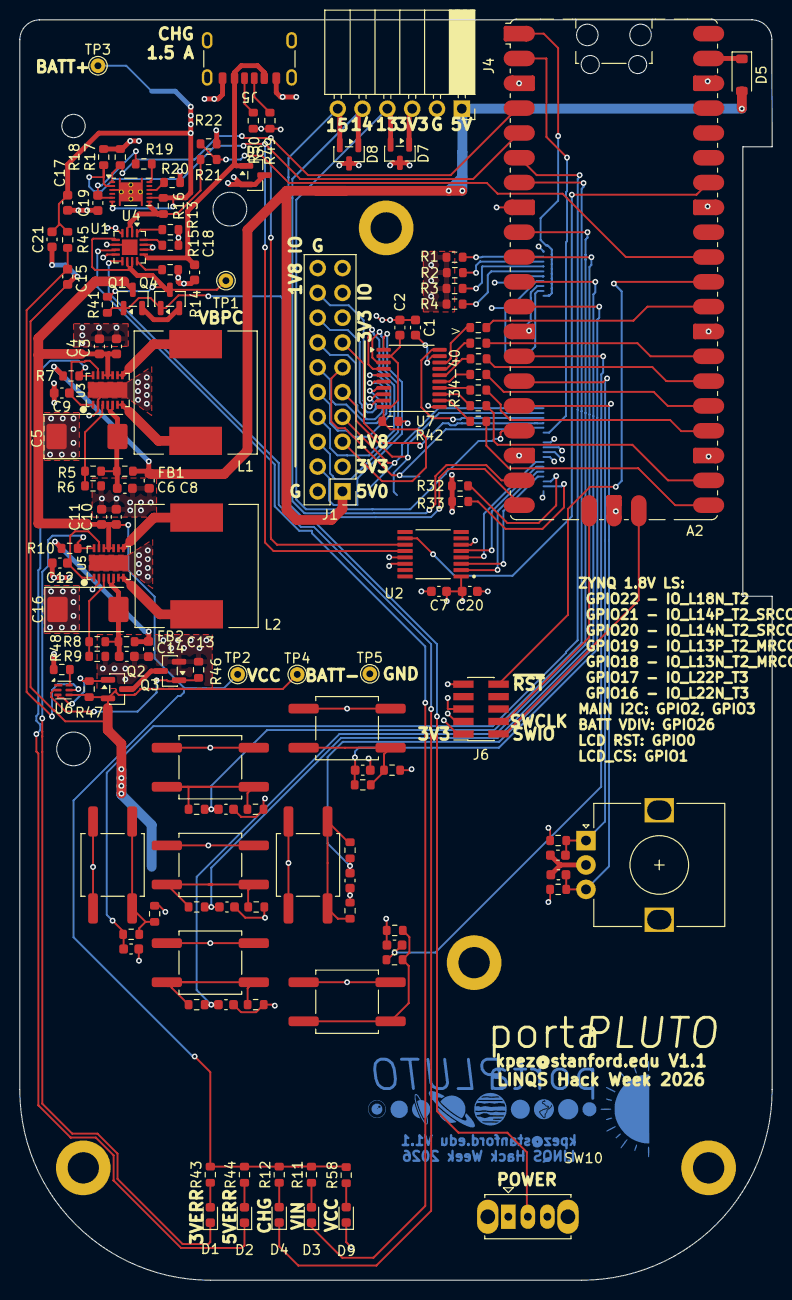
[picture p10: board plutopack.kicad_pcb from above]

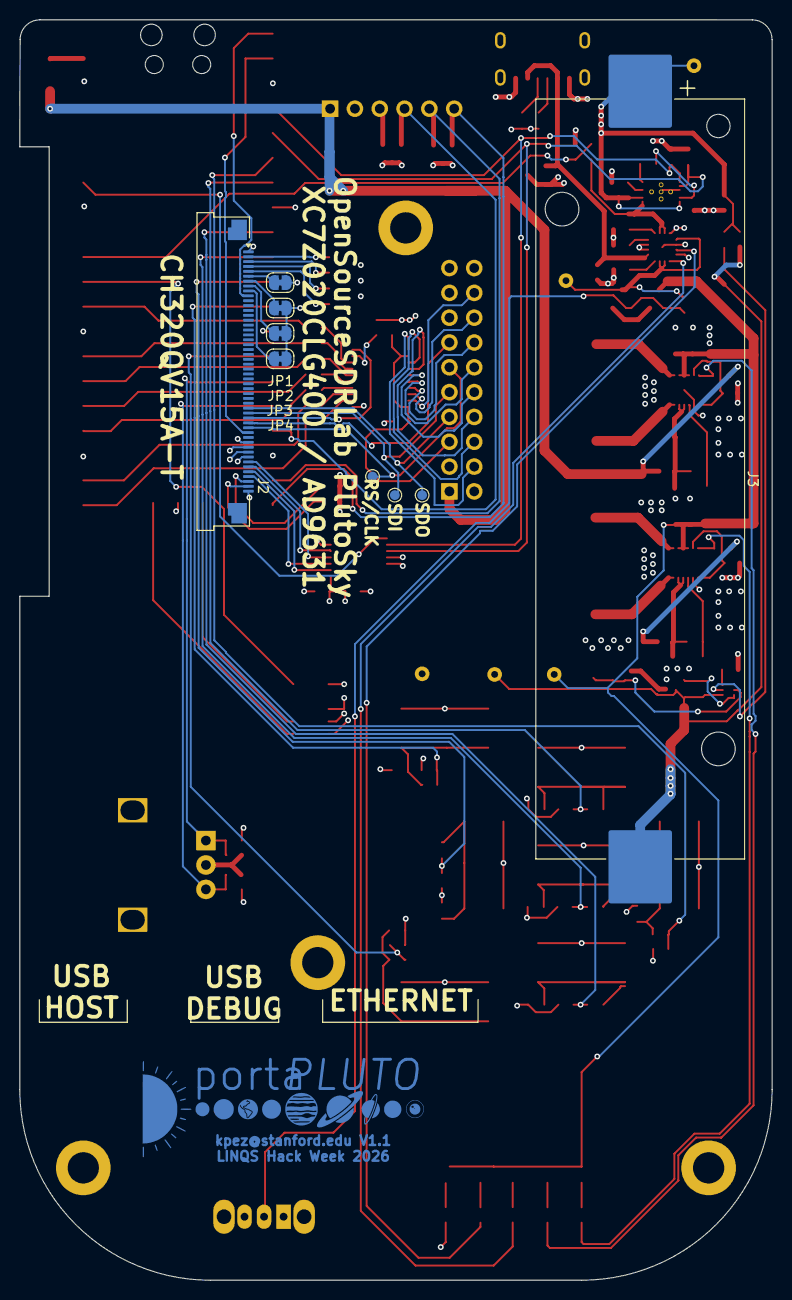
[picture p11: board plutopack.kicad_pcb from below]

Board: 4 copper layers, 77.0 x 129.0 mm, 144 parts (9 on the bottom side), 114 nets.
