kpezeshki/portaPLUTO/plutopack_release/zynq-firmware/overlay/package/plutopack-panel/src/pp_font.c

#include "pp_screen.h"
/* IBM VGA 8x8 (Lat15-VGA8.psf), ASCII 0x20-0x7f */
const uint8_t PP_FONT8[96][8] = {
  {0x00,0x00,0x00,0x00,0x00,0x00,0x00,0x00}, // 0x20 ' '
  {0x18,0x3c,0x3c,0x18,0x18,0x00,0x18,0x00}, // 0x21 '!'
  {0x66,0x66,0x24,0x00,0x00,0x00,0x00,0x00}, // 0x22 '"'
  {0x6c,0x6c,0xfe,0x6c,0xfe,0x6c,0x6c,0x00}, // 0x23 '#'
  {0x18,0x3e,0x60,0x3c,0x06,0x7c,0x18,0x00}, // 0x24 '$'
  {0x00,0xc6,0xcc,0x18,0x30,0x66,0xc6,0x00}, // 0x25 '%'
  {0x38,0x6c,0x38,0x76,0xdc,0xcc,0x76,0x00}, // 0x26 '&'
  {0x18,0x18,0x30,0x00,0x00,0x00,0x00,0x00}, // 0x27 "'"
  {0x0c,0x18,0x30,0x30,0x30,0x18,0x0c,0x00}, // 0x28 '('
  {0x30,0x18,0x0c,0x0c,0x0c,0x18,0x30,0x00}, // 0x29 ')'
  {0x00,0x66,0x3c,0xff,0x3c,0x66,0x00,0x00}, // 0x2a '*'
  {0x00,0x18,0x18,0x7e,0x18,0x18,0x00,0x00}, // 0x2b '+'
  {0x00,0x00,0x00,0x00,0x00,0x18,0x18,0x30}, // 0x2c ','
  {0x00,0x00,0x00,0x7e,0x00,0x00,0x00,0x00}, // 0x2d '-'
  {0x00,0x00,0x00,0x00,0x00,0x18,0x18,0x00}, // 0x2e '.'
  {0x06,0x0c,0x18,0x30,0x60,0xc0,0x80,0x00}, // 0x2f '/'
  {0x38,0x6c,0xc6,0xd6,0xc6,0x6c,0x38,0x00}, // 0x30 '0'
  {0x18,0x38,0x18,0x18,0x18,0x18,0x7e,0x00}, // 0x31 '1'
  {0x7c,0xc6,0x06,0x1c,0x30,0x66,0xfe,0x00}, // 0x32 '2'
  {0x7c,0xc6,0x06,0x3c,0x06,0xc6,0x7c,0x00}, // 0x33 '3'
  {0x1c,0x3c,0x6c,0xcc,0xfe,0x0c,0x1e,0x00}, // 0x34 '4'
  {0xfe,0xc0,0xc0,0xfc,0x06,0xc6,0x7c,0x00}, // 0x35 '5'
  {0x38,0x60,0xc0,0xfc,0xc6,0xc6,0x7c,0x00}, // 0x36 '6'
  {0xfe,0xc6,0x0c,0x18,0x30,0x30,0x30,0x00}, // 0x37 '7'
  {0x7c,0xc6,0xc6,0x7c,0xc6,0xc6,0x7c,0x00}, // 0x38 '8'
  {0x7c,0xc6,0xc6,0x7e,0x06,0x0c,0x78,0x00}, // 0x39 '9'
  {0x00,0x18,0x18,0x00,0x00,0x18,0x18,0x00}, // 0x3a ':'
  {0x00,0x18,0x18,0x00,0x00,0x18,0x18,0x30}, // 0x3b ';'
  {0x06,0x0c,0x18,0x30,0x18,0x0c,0x06,0x00}, // 0x3c '<'
  {0x00,0x00,0x7e,0x00,0x00,0x7e,0x00,0x00}, // 0x3d '='
  {0x60,0x30,0x18,0x0c,0x18,0x30,0x60,0x00}, // 0x3e '>'
  {0x7c,0xc6,0x0c,0x18,0x18,0x00,0x18,0x00}, // 0x3f '?'
  {0x7c,0xc6,0xde,0xde,0xde,0xc0,0x78,0x00}, // 0x40 '@'
  {0x38,0x6c,0xc6,0xfe,0xc6,0xc6,0xc6,0x00}, // 0x41 'A'
  {0xfc,0x66,0x66,0x7c,0x66,0x66,0xfc,0x00}, // 0x42 'B'
  {0x3c,0x66,0xc0,0xc0,0xc0,0x66,0x3c,0x00}, // 0x43 'C'
  {0xf8,0x6c,0x66,0x66,0x66,0x6c,0xf8,0x00}, // 0x44 'D'
  {0xfe,0x62,0x68,0x78,0x68,0x62,0xfe,0x00}, // 0x45 'E'
  {0xfe,0x62,0x68,0x78,0x68,0x60,0xf0,0x00}, // 0x46 'F'
  {0x3c,0x66,0xc0,0xc0,0xce,0x66,0x3a,0x00}, // 0x47 'G'
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
};
