kpezeshki/portaPLUTO/(commit log)

2026-08-21 added source, pcb, mechanical design files
2026-08-21 Update warning about powering system before connection
2026-10-26 Update frontend PCB to latest revision
    Sync plutopack_frontend_pcb with the latest KiCad layout, power_management
    schematic changes, and regenerated JLC production outputs (BOM, positions,
    netlist, gerber zip).
2026-10-26 Use project-relative paths in KiCad library tables
2026-11-12 Clarify V1.1 verification and current panel features
