kpezeshki/portaPLUTO/(notices)

Notices in the files:
plutopack_release/fpga/projects/fishball_iio/system_top.v:
of this file, are permitted under one of the following two license terms: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
